DangerousPrototypes/bus_pirate_ng/README.md

# bus_pirate_ng
Bus Pirate NG firmware and hardware

Check the blog at http://dangerousprototypes.com/blog/2018/09/13/prototype-bus-pirate-next-gen-v1/
