DangerousPrototypes/bus_pirate_ng/(threads)

Thread 5 (2018-12-12):

DFuse format string

Squonk42, 2018-12-12:
https://github.com/DangerousPrototypes/bus_pirate_ng/blob/d68bd6ecd64ba1823aafadaffa73d94cadd74560/bootloader/usbdfu.c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

No, this is not correct for 128KB STM32 chips, according to [this](https://git.drak.xyz/flabbergast/opencm3-ex/src/commit/ef9fd2db6a21d4f1ae8ad4e156e27370e8926ce1/usb_dfu/usbdfu.c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), here is the correct format:
```
/* Notes about the dfuse string above:
 * /<start_address>/<number>*<page_size><multiplier><memtype>
 *  <number>: how many pages
 *  <page_size>: self explanatory
 *  <multiplier>: 'B'(ytes), 'K'(ilobytes), 'M'(egabytes)
 *  <memtype>: the bottom three bits are significant:
 *             writeable|erasable|readable
 * subsequent blocks separated by commas
 *
 * Using the internal page size: "@Internal Flash   /0x08000000/64*128Ba,448*128Bg"
 * Using 1K blocks: "@Internal Flash   /0x08000000/8*001Ka,56*001Kg"
 */

```

Thread 7 (2019-05-25):

Misc questions

FFY00, 2019-05-25:
1) Can you tell me if with the STM32 we get faster JTAG programming speeds?
2) Is there any ETA on the first stable hardware revision?
3) What is the current state of development?
4) Are there any gotchas?

I am considering building prototype and maybe help with the development.
