DangerousPrototypes/bus_pirate_ng/hardware/alpha3/BusPirate-ng.v1.0.brd

## EAGLE design hardware/alpha3/BusPirate-ng.v1.0.brd (2018-09-13)

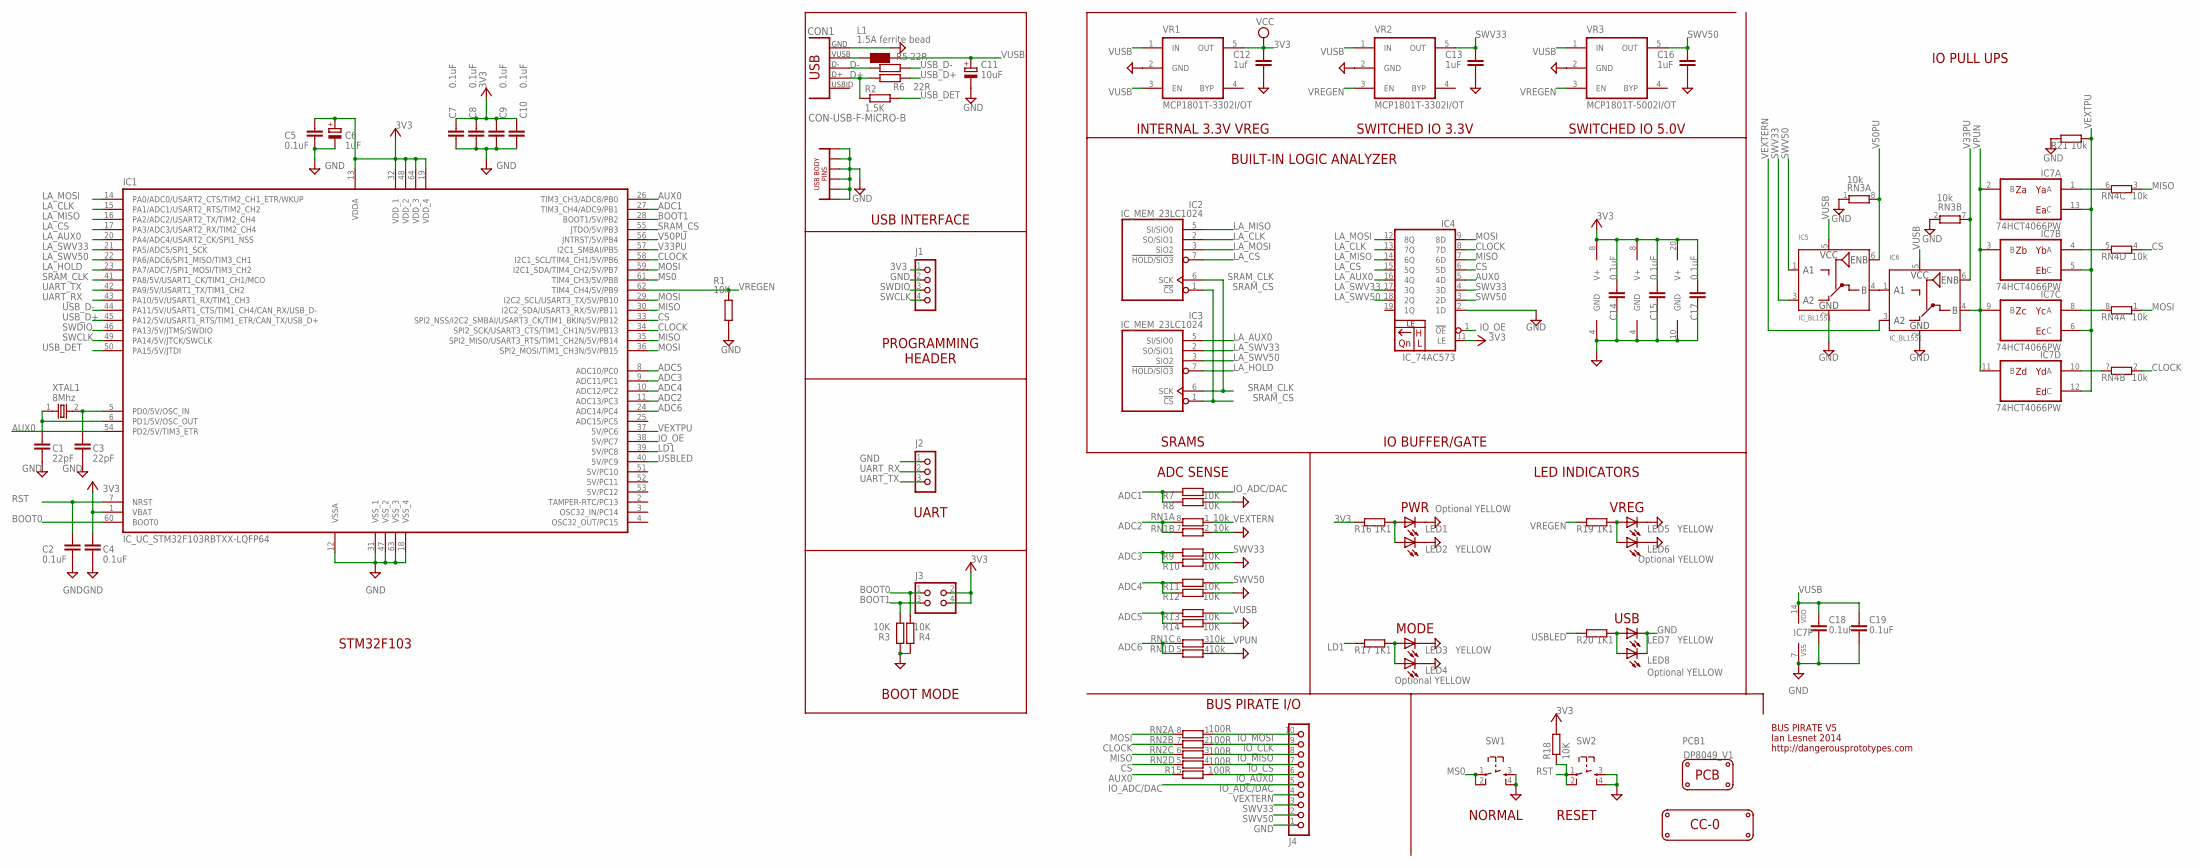
[picture p1: schematic BusPirate-ng.v1.0.sch]

Parts:
C1, C3: 22pF; C0603
C2, C4, C5, C7, C8, C9, C10, C14, C15, C17, C18, C19: 0.1uF; C0603
C6: 1uF; SMC_A
C11: 10uF; SMC_A
C12: 1uf; C0603
C13, C16: 1uF; C0603
CON1: CON-USB-F-MICRO-B; CON_USB_MICRO-B-1-MD05SMXXX-01
IC1: IC_UC_STM32F103RBTXX-LQFP64; LQFP64
IC2, IC3: IC_MEM_23LC1024; SOIC-8
IC4: IC_74AC573; TSSOP-20
IC5, IC6: IC_BL1551; SOT-363
IC7: 74HCT4066PW; 40XX_TSSOP14
J1: CON_HEADER_1X04; M1X4
J2: CON_HEADER_1X03-PTH; M1X3
J3: CON_HEADER_2X02-PTH; M2X2
J4: CON_HEADER_1X10-RIGHT_ANGLED_PTH_SHROUDED; M1X10_MALE_RIGHT_ANGLES_PTH_SHROUDED
L1: 1.5A ferrite bead; WE-KI_0805_B
LED1, LED4, LED6, LED8: Optional YELLOW; LED-805
LED2, LED3, LED5, LED7: YELLOW; LED-805
LOGO1: LOGO_CC-0
PCB1: PCB_DP_RECTANGLE-80X49; DP8049_V1
R1, R18: 10K; R603
R2: 1.5K; R603
R3, R4, R7, R8, R9, R10, R11, R12, R13, R14: 10K; R0603
R5, R6: 22R; R603
R15: 100R; R603
R16, R17, R19, R20: 1K1; R603
R21: 10k; R603
RN1, RN3, RN4: 10k; RN8P-4R-CRA06S
RN2: 100R; RN8P-4R-CRA06S
SW1, SW2: SW_TACT_4P; SW_TACT_SMALL
VR1, VR2: MCP1801T-3302I/OT; SOT-23-5@1
VR3: MCP1801T-5002I/OT; SOT-23-5@1
XTAL1: 8Mhz; XTAL_4X6

Connections:
3V3: C4.2, C5.2, C6.+, C7.2, C8.2, C9.2, C10.2, C12.1, C14.1, C15.1, C17.1, IC1.1 (VBAT), IC1.13 (VDDA), IC1.19 (VDD_4), IC1.32 (VDD_1), IC1.48 (VDD_2), IC1.64 (VDD_3), IC2.8 (V+), IC3.8 (V+), IC4.11 (LE), IC4.20 (V+), J1.1, J3.2, J3.4, R16.2, R18.2, VR1.5 (OUT)
ADC1: IC1.27 (TIM3_CH4/ADC9/PB1), R7.2, R8.2
ADC2: IC1.11 (ADC13/PC3), RN1.7 (2), RN1.8 (2)
ADC3: IC1.9 (ADC11/PC1), R9.2, R10.2
ADC4: IC1.10 (ADC12/PC2), R11.2, R12.2
ADC5: IC1.8 (ADC10/PC0), R13.2, R14.2
ADC6: IC1.24 (ADC14/PC4), RN1.5 (2), RN1.6 (2)
AUX0: IC1.26 (TIM3_CH3/ADC8/PB0), IC1.54 (PD2/5V/TIM3_ETR), IC4.5 (4D), R15.1
BOOT0: IC1.60 (BOOT0), J3.1, R4.1
BOOT1: IC1.28 (BOOT1/5V/PB2), J3.3, R3.1
CLOCK: IC1.34 (SPI2_SCK/USART3_CTS/TIM1_CH1N/5V/PB13), IC1.58 (I2C1_SCL/TIM4_CH1/5V/PB6), IC4.8 (7D), RN2.7 (2), RN4.2 (1)
CS: IC1.33 (SPI2_NSS/I2C2_SMBAI/USART3_CK/TIM1_BKIN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), IC4.6 (5D), RN2.5 (2), RN4.4 (1)
D+: CON1.P3 (D+), R2.1, R6.2
D-: CON1.P2 (D-), R5.2
EXVUSB: CON1.P1 (VUSB), L1.2 (1)
GND: C1.1, C2.1, C3.1, C4.1, C5.1, C6.-, C7.1, C8.1, C9.1, C10.1, C11.-, C12.2, C13.2, C14.2, C15.2, C16.2, C17.2, C18.2, C19.2, CON1.GND1, CON1.GND2, CON1.GND3, CON1.GND4, CON1.GND5, CON1.GND6, CON1.P5 (GND), IC1.12 (VSSA), IC1.18 (VSS_4), IC1.31 (VSS_1), IC1.47 (VSS_2), IC1.63 (VSS_3), IC2.4 (GND), IC3.4 (GND), IC4.2 (1D), IC4.10 (GND), IC5.2 (GND), IC6.2 (GND), IC7.7 (VSS), J1.2, J2.1, J4.1, LED1.C, LED2.C, LED3.C, LED4.C, LED5.C, LED6.C, LED7.C, LED8.C, R1.2, R3.2, R4.2, R8.1, R10.1, R12.1, R14.1, R21.2, RN1.2 (1), RN1.4 (1), RN3.1, RN3.2 (1), SW1.3, SW1.4, SW2.3, SW2.4, VR1.2 (GND), VR2.2 (GND), VR3.2 (GND)
IO_ADC/DAC: J4.5, R7.1
IO_AUX0: J4.6, R15.2
IO_CLK: J4.9, RN2.2 (1)
IO_CS: J4.7, RN2.4 (1)
IO_MISO: J4.8, RN2.3 (1)
IO_MOSI: J4.10, RN2.1
IO_OE: IC1.38 (5V/PC7), IC4.1 (!OE)
LA_AUX0: IC1.20 (PA4/ADC4/USART2_CK/SPI1_NSS), IC3.5 (SI/SIO0), IC4.16 (4Q)
LA_CLK: IC1.15 (PA1/ADC1/USART2_RTS/TIM2_CH2), IC2.2 (SO/SIO1), IC4.13 (7Q)
LA_CS: IC1.17 (PA3/ADC3/USART2_RX/TIM2_CH4), IC2.7 (!HOLD/SIO3), IC4.15 (5Q)
LA_HOLD: IC1.23 (PA7/ADC7/SPI1_MOSI/TIM3_CH2), IC3.7 (!HOLD/SIO3)
LA_MISO: IC1.16 (PA2/ADC2/USART2_TX/TIM2_CH4), IC2.5 (SI/SIO0), IC4.14 (6Q)
LA_MOSI: IC1.14 (PA0/ADC0/USART2_CTS/TIM2_CH1_ETR/WKUP), IC2.3 (SIO2), IC4.12 (8Q)
LA_SWV33: IC1.21 (PA5/ADC5/SPI1_SCK), IC3.2 (SO/SIO1), IC4.17 (3Q)
LA_SWV50: IC1.22 (PA6/ADC6/SPI1_MISO/TIM3_CH1), IC3.3 (SIO2), IC4.18 (2Q)
LD1: IC1.39 (5V/PC8), R17.2
MISO: IC1.30 (I2C2_SDA/USART3_RX/5V/PB11), IC1.35 (SPI2_MISO/USART3_RTS/TIM1_CH2N/5V/PB14), IC4.7 (6D), RN2.6 (2), RN4.3 (1)
MOSI: IC1.29 (I2C2_SCL/USART3_TX/5V/PB10), IC1.36 (SPI2_MOSI/TIM1_CH3N/5V/PB15), IC1.59 (I2C1_SDA/TIM4_CH2/5V/PB7), IC4.9 (8D), RN2.8 (2), RN4.1
MS0: IC1.61 (TIM4_CH3/5V/PB8), SW1.1, SW1.2
unnamed: IC5.4 (B), IC6.1 (A1)
unnamed: IC7.1 (A), RN4.6 (2)
unnamed: IC7.4 (A), RN4.5 (2)
unnamed: IC7.8 (A), RN4.8 (2)
unnamed: IC7.10 (A), RN4.7 (2)
unnamed: LED3.A, LED4.A, R17.1
unnamed: LED1.A, LED2.A, R16.1
unnamed: LED7.A, LED8.A, R20.1
unnamed: C3.2, IC1.5 (PD0/5V/OSC_IN), XTAL1.2
unnamed: LED5.A, LED6.A, R19.1
unnamed: C1.2, IC1.6 (PD1/5V/OSC_OUT), XTAL1.1
RST: C2.2, IC1.7 (NRST), R18.1, SW2.1, SW2.2
SRAM_CLK: IC1.41 (PA8/5V/USART1_CK/TIM1_CH1/MCO), IC2.6 (SCK), IC3.6 (SCK)
SRAM_CS: IC1.55 (JTDO/5V/PB3), IC2.1 (!CS), IC3.1 (!CS)
SWCLK: IC1.49 (PA14/5V/JTCK/SWCLK), J1.4
SWDIO: IC1.46 (PA13/5V/JTMS/SWDIO), J1.3
SWV33: C13.1, IC4.4 (3D), IC5.3 (A2), J4.3, R9.1, VR2.5 (OUT)
SWV50: C16.1, IC4.3 (2D), IC5.1 (A1), J4.2, R11.1, VR3.5 (OUT)
UART_RX: IC1.43 (PA10/5V/USART1_RX/TIM1_CH3), J2.2
UART_TX: IC1.42 (PA9/5V/USART1_TX/TIM1_CH2), J2.3
USBLED: IC1.40 (5V/PC9), R20.2
USB_D+: IC1.45 (PA12/5V/USART1_RTS/TIM1_ETR/CAN_TX/USB_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), R6.1
USB_D-: IC1.44 (PA11/5V/USART1_CTS/TIM1_CH4/CAN_RX/USB_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), R5.1
USB_DET: IC1.50 (PA15/5V/JTDI), R2.2
V33PU: IC1.57 (I2C1_SMBAI/PB5), IC6.6 (ENB), RN3.7 (2)
V50PU: IC1.56 (JNTRST/5V/PB4), IC5.6 (ENB), RN3.8 (2)
VEXTERN: IC6.3 (A2), J4.4, RN1.1
VEXTPU: IC1.37 (5V/PC6), IC7.5 (C), IC7.6 (C), IC7.12 (C), IC7.13 (C), R21.1
VPUN: IC6.4 (B), IC7.2 (B), IC7.3 (B), IC7.9 (B), IC7.11 (B), RN1.3 (1)
VREGEN: IC1.62 (TIM4_CH4/5V/PB9), R1.1, R19.2, VR2.3 (EN), VR3.3 (EN)
VUSB: C11.+, C18.1, C19.1, IC5.5 (VCC), IC6.5 (VCC), IC7.14 (VDD), L1.1 (2), R13.1, VR1.1 (IN), VR1.3 (EN), VR2.1 (IN), VR3.1 (IN)

Notes on the sheet:
BUS PIRATE V5
Ian Lesnet 2014
http://dangerousprototypes.com
SRAMS
IO BUFFER/GATE
BUS PIRATE I/O
BOOT MODE
PWR
MODE
VREG
PROGRAMMING HEADER
USB
INTERNAL 3.3V VREG
SWITCHED IO 3.3V
SWITCHED IO 5.0V
BUILT-IN LOGIC ANALYZER
ADC SENSE
USB INTERFACE
STM32F103
NORMAL
RESET
IO PULL UPS
LED INDICATORS
UART

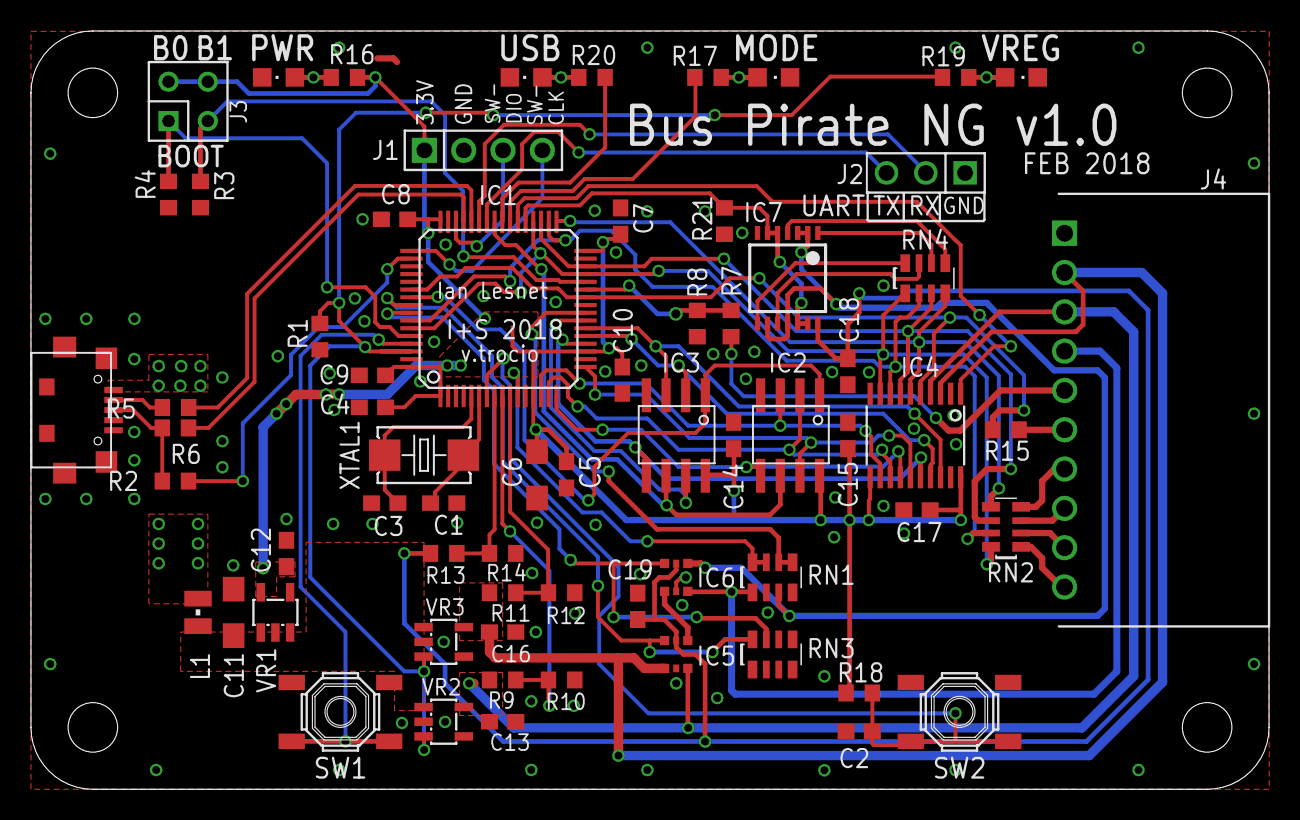
[picture p2: board BusPirate-ng.v1.0.brd from above]

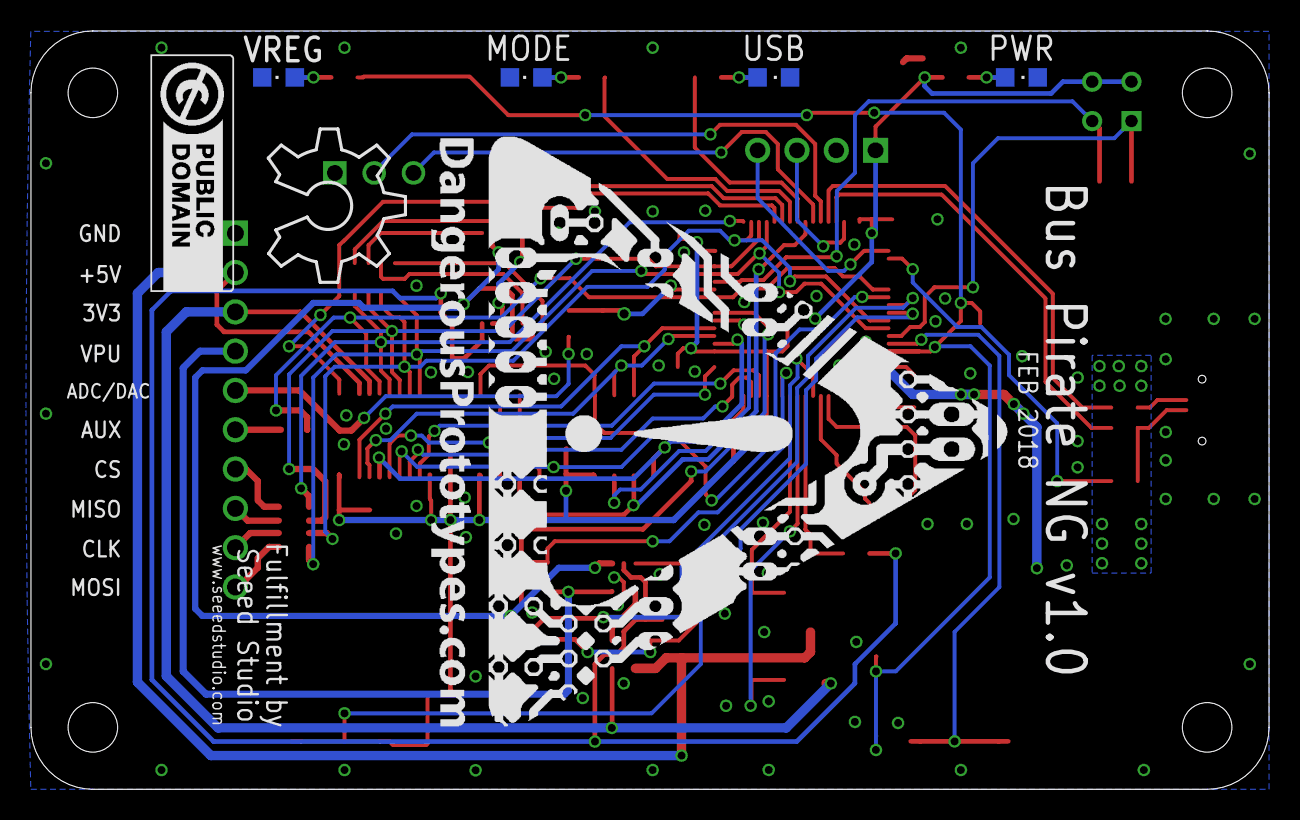
[picture p3: board BusPirate-ng.v1.0.brd from below]

Board: 2 copper layers, 80.0 x 49.0 mm, 76 parts (7 on the bottom side), 66 nets.

Other parts of the board:
U$1: DP-LOGO
U$2: OSHW_8X350_NOTEXT
U$4: DP_LOGO_ART_1.5X1.5
