DangerousPrototypes/bus_pirate_ng/hardware/alpha1/BusPirate-v5.brd

## EAGLE design hardware/alpha1/BusPirate-v5.brd (2017-12-20)

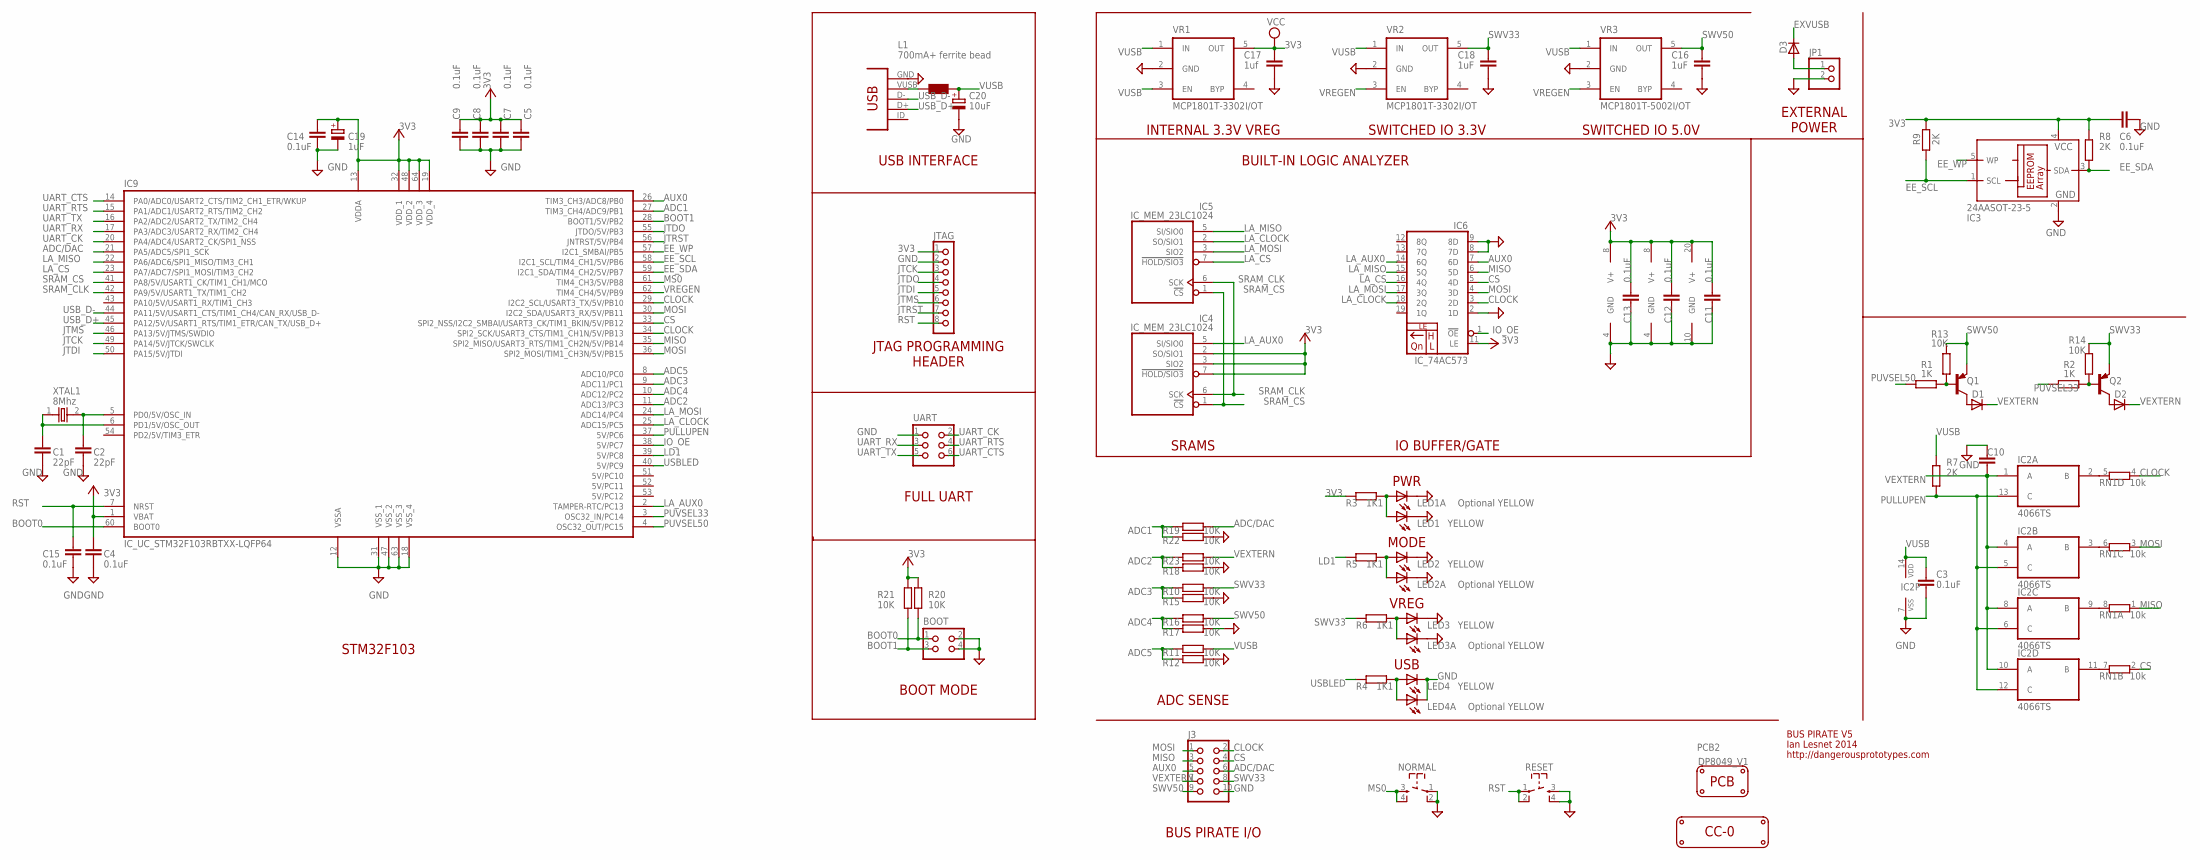
[picture p4: schematic BusPirate-v5.sch]

Parts:
BOOT: CON_HEADER_2X02-PTH; M2X2
C1, C2: 22pF; C0603
C3, C4, C5, C6, C7, C8, C9, C10, C11, C12, C13, C14, C15: 0.1uF; C0603
C16, C18: 1uF; C0603
C17: 1uf; C0603
C19: 1uF; SMC_A
C20: 10uF; SMC_A
D1, D2, D3: MBR0520LT; SOD123
IC2: 4066TS; 40XX_TSSOP14
IC3: 24AASOT-23-5; SOT-23-5@1
IC4, IC5: IC_MEM_23LC1024; SOIC-8
IC6: IC_74AC573; TSSOP-20
IC9: IC_UC_STM32F103RBTXX-LQFP64; LQFP64
J3: CON_HEADER_2X05-PTH+SHROUDED_A; PINSHRD_PTH_2X05
JP1: PINHD-1X02_2.54-S; 1X02-S
JTAG: CON_HEADER_1X08-PTH; M1X8
L1: 700mA+ ferrite bead; WE-KI_0805_B
LED1, LED2, LED3, LED4: YELLOW; LED-603
LED1A, LED2A, LED3A, LED4A: Optional YELLOW; LED-603
LOGO1: LOGO_CC-0
NORMAL: SW_TACT_4P; SW_TACT_SMALL
PCB2: PCB_DP_RECTANGLE-80X49; DP8049_V1
Q1, Q2: MMBTA56-SOT23; SOT23
R1, R2: 1K; R0603
R3, R4, R5, R6: 1K1; R603
R7, R8, R9: 2K; R0603
R10, R11, R12, R14, R15, R16, R17, R18, R19, R20, R21, R22, R23: 10K; R0603
R13: 10K; R603
RESET: SW_TACT_4P; SW_TACT_SMALL
RN1: 10k; RN8P-4R-CRA06S
UART: CON_HEADER_2X03-PTH; M2X3
USB: USB mini-b; CONN_USB_MINI-B
VR1, VR2: MCP1801T-3302I/OT; SOT-23-5@1
VR3: MCP1801T-5002I/OT; SOT-23-5@1
XTAL1: 8Mhz; XTAL_4X6

Connections:
3V3: C4.2, C5.2, C6.1, C7.2, C8.2, C9.2, C11.1, C12.1, C13.1, C14.2, C17.1, C19.+, IC3.4 (VCC), IC4.2 (SO/SIO1), IC4.3 (SIO2), IC4.7 (!HOLD/SIO3), IC4.8 (V+), IC5.8 (V+), IC6.11 (LE), IC6.20 (V+), IC9.1 (VBAT), IC9.13 (VDDA), IC9.19 (VDD_4), IC9.32 (VDD_1), IC9.48 (VDD_2), IC9.64 (VDD_3), JTAG.1, R3.2, R8.2, R9.2, R20.2, R21.2, VR1.5 (OUT)
ADC1: IC9.27 (TIM3_CH4/ADC9/PB1), R19.2, R22.2
ADC2: IC9.11 (ADC13/PC3), R18.2, R23.2
ADC3: IC9.9 (ADC11/PC1), R10.2, R15.2
ADC4: IC9.10 (ADC12/PC2), R16.2, R17.2
ADC5: IC9.8 (ADC10/PC0), R11.2, R12.2
ADC/DAC: IC9.21 (PA5/ADC5/SPI1_SCK), J3.6, R19.1
AUX0: IC6.7 (6D), IC9.26 (TIM3_CH3/ADC8/PB0), J3.5
BOOT0: BOOT.1, IC9.60 (BOOT0), R20.1
BOOT1: BOOT.3, IC9.28 (BOOT1/5V/PB2), R21.1
CLOCK: IC6.3 (2D), IC9.29 (I2C2_SCL/USART3_TX/5V/PB10), IC9.34 (SPI2_SCK/USART3_CTS/TIM1_CH1N/5V/PB13), J3.2, RN1.4 (1)
CS: IC6.5 (4D), IC9.33 (SPI2_NSS/I2C2_SMBAI/USART3_CK/TIM1_BKIN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), J3.4, RN1.2 (1)
EE_SCL: IC3.1 (SCL), IC9.58 (I2C1_SCL/TIM4_CH1/5V/PB6), R9.1
EE_SDA: IC3.3 (SDA), IC9.59 (I2C1_SDA/TIM4_CH2/5V/PB7), R8.1
EE_WP: IC3.5 (WP), IC9.57 (I2C1_SMBAI/PB5)
EXVUSB: D3.C, L1.2 (1), USB.VUSB
GND: BOOT.2, BOOT.4, C1.1, C2.1, C3.2, C4.1, C5.1, C6.2, C7.1, C8.1, C9.1, C10.2, C11.2, C12.2, C13.2, C14.1, C15.1, C16.2, C17.2, C18.2, C19.-, C20.-, IC2.7 (VSS), IC3.2 (GND), IC4.4 (GND), IC5.4 (GND), IC6.2 (1D), IC6.8 (7D), IC6.9 (8D), IC6.10 (GND), IC9.12 (VSSA), IC9.18 (VSS_4), IC9.31 (VSS_1), IC9.47 (VSS_2), IC9.63 (VSS_3), J3.10, JP1.2, JTAG.2, LED1.C, LED1A.C, LED2.C, LED2A.C, LED3.C, LED3A.C, LED4.C, LED4A.C, NORMAL.1, NORMAL.2, R12.1, R15.1, R17.1, R18.1, R22.1, RESET.3, RESET.4, UART.1, USB.GND, VR1.2 (GND), VR2.2 (GND), VR3.2 (GND)
IO_OE: IC6.1 (!OE), IC9.38 (5V/PC7)
JTCK: IC9.49 (PA14/5V/JTCK/SWCLK), JTAG.3
JTDI: IC9.50 (PA15/5V/JTDI), JTAG.5
JTDO: IC9.55 (JTDO/5V/PB3), JTAG.4
JTMS: IC9.46 (PA13/5V/JTMS/SWDIO), JTAG.6
JTRST: IC9.56 (JNTRST/5V/PB4), JTAG.7
LA_AUX0: IC4.5 (SI/SIO0), IC6.14 (6Q), IC9.2 (TAMPER-RTC/PC13)
LA_CLOCK: IC5.2 (SO/SIO1), IC6.18 (2Q), IC9.25 (ADC15/PC5)
LA_CS: IC5.7 (!HOLD/SIO3), IC6.16 (4Q), IC9.23 (PA7/ADC7/SPI1_MOSI/TIM3_CH2)
LA_MISO: IC5.5 (SI/SIO0), IC6.15 (5Q), IC9.22 (PA6/ADC6/SPI1_MISO/TIM3_CH1)
LA_MOSI: IC5.3 (SIO2), IC6.17 (3Q), IC9.24 (ADC14/PC4)
LD1: IC9.39 (5V/PC8), R5.2
MISO: IC6.6 (5D), IC9.35 (SPI2_MISO/USART3_RTS/TIM1_CH2N/5V/PB14), J3.3, RN1.1
MOSI: IC6.4 (3D), IC9.30 (I2C2_SDA/USART3_RX/5V/PB11), IC9.36 (SPI2_MOSI/TIM1_CH3N/5V/PB15), J3.1, RN1.3 (1)
MS0: IC9.61 (TIM4_CH3/5V/PB8), NORMAL.3, NORMAL.4
unnamed: IC2.2 (B), RN1.5 (2)
unnamed: IC2.11 (B), RN1.7 (2)
unnamed: D1.A, Q1.3 (C)
unnamed: IC2.9 (B), RN1.8 (2)
unnamed: IC2.3 (B), RN1.6 (2)
unnamed: LED2.A, LED2A.A, R5.1
unnamed: LED1.A, LED1A.A, R3.1
unnamed: Q2.1 (B), R2.1, R14.2
unnamed: LED4.A, LED4A.A, R4.1
unnamed: D2.A, Q2.3 (C)
unnamed: D3.A, JP1.1
unnamed: C2.2, IC9.5 (PD0/5V/OSC_IN), XTAL1.2
unnamed: Q1.1 (B), R1.1, R13.2
unnamed: LED3.A, LED3A.A, R6.1
unnamed: C1.2, IC9.6 (PD1/5V/OSC_OUT), XTAL1.1
PULLUPEN: IC2.5 (C), IC2.6 (C), IC2.12 (C), IC2.13 (C), IC9.37 (5V/PC6), R7.2
PUVSEL33: IC9.3 (OSC32_IN/PC14), R2.2
PUVSEL50: IC9.4 (OSC32_OUT/PC15), R1.2
RST: C15.2, IC9.7 (NRST), JTAG.8, RESET.1, RESET.2
SRAM_CLK: IC4.6 (SCK), IC5.6 (SCK), IC9.42 (PA9/5V/USART1_TX/TIM1_CH2)
SRAM_CS: IC4.1 (!CS), IC5.1 (!CS), IC9.41 (PA8/5V/USART1_CK/TIM1_CH1/MCO)
SWV33: C18.1, J3.8, Q2.2 (E), R6.2, R10.1, R14.1, VR2.5 (OUT)
SWV50: C16.1, J3.9, Q1.2 (E), R13.1, R16.1, VR3.5 (OUT)
UART_CK: IC9.20 (PA4/ADC4/USART2_CK/SPI1_NSS), UART.2
UART_CTS: IC9.14 (PA0/ADC0/USART2_CTS/TIM2_CH1_ETR/WKUP), UART.6
UART_RTS: IC9.15 (PA1/ADC1/USART2_RTS/TIM2_CH2), UART.4
UART_RX: IC9.17 (PA3/ADC3/USART2_RX/TIM2_CH4), UART.3
UART_TX: IC9.16 (PA2/ADC2/USART2_TX/TIM2_CH4), UART.5
USBLED: IC9.40 (5V/PC9), R4.2
USB_D+: IC9.45 (PA12/5V/USART1_RTS/TIM1_ETR/CAN_TX/USB_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), USB.D+
USB_D-: IC9.44 (PA11/5V/USART1_CTS/TIM1_CH4/CAN_RX/USB_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), USB.D-
VEXTERN: C10.1, D1.C, D2.C, IC2.1 (A), IC2.4 (A), IC2.8 (A), IC2.10 (A), J3.7, R23.1
VREGEN: IC9.62 (TIM4_CH4/5V/PB9), VR2.3 (EN), VR3.3 (EN)
VUSB: C3.1, C20.+, IC2.14 (VDD), L1.1 (2), R7.1, R11.1, VR1.1 (IN), VR1.3 (EN), VR2.1 (IN), VR3.1 (IN)

Notes on the sheet:
BUS PIRATE V5
Ian Lesnet 2014
http://dangerousprototypes.com
SRAMS
IO BUFFER/GATE
FULL UART
BUS PIRATE I/O
BOOT MODE
PWR
MODE
VREG
JTAG PROGRAMMING HEADER
USB
INTERNAL 3.3V VREG
SWITCHED IO 3.3V
SWITCHED IO 5.0V
BUILT-IN LOGIC ANALYZER
ADC SENSE
USB INTERFACE
STM32F103
EXTERNAL POWER

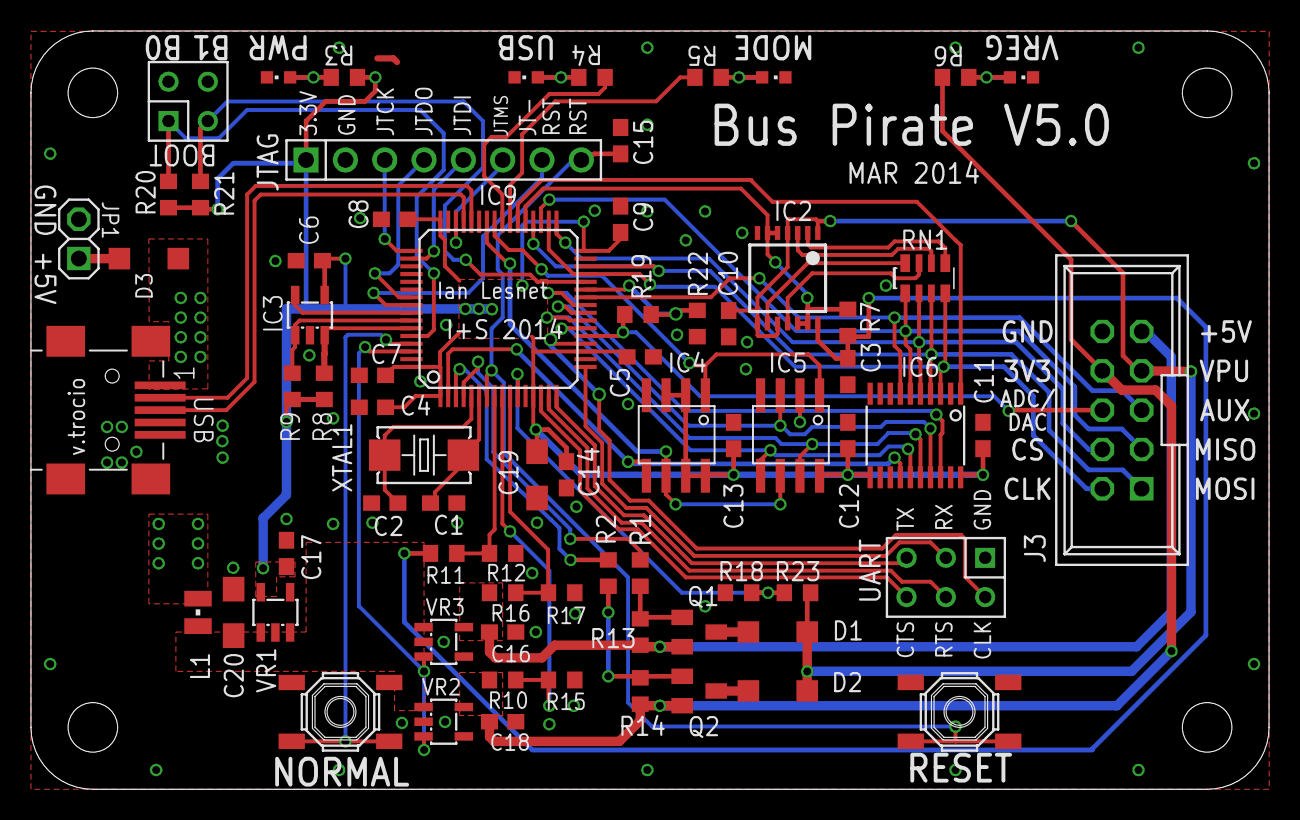
[picture p5: board BusPirate-v5.brd from above]

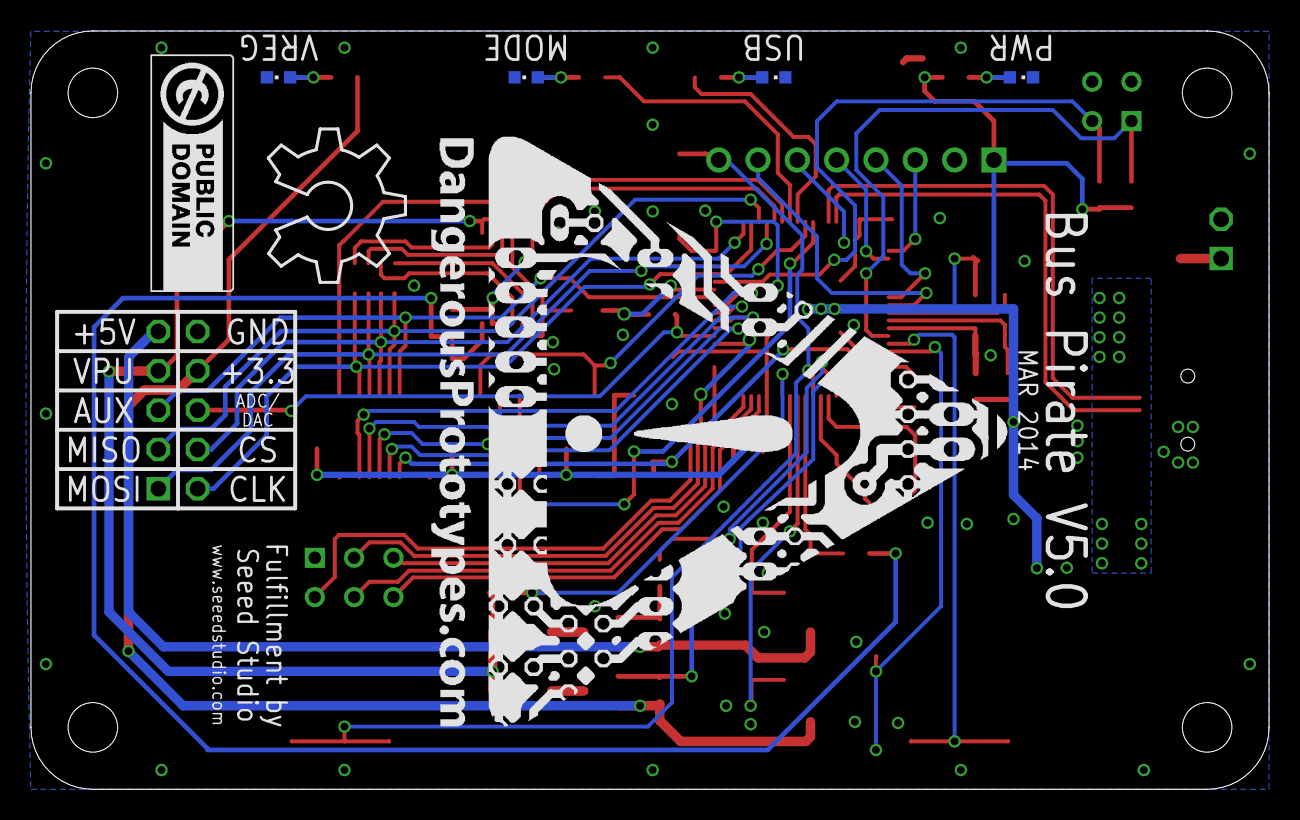
[picture p6: board BusPirate-v5.brd from below]

Board: 2 copper layers, 80.0 x 49.0 mm, 80 parts (7 on the bottom side), 66 nets.

Other parts of the board:
U$2: OSHW_8X350_NOTEXT
U$4: DP_LOGO_ART_1.5X1.5
