DangerousPrototypes/bus_pirate_ng/source/usbdescriptor.h

#ifndef USB_VID
#error "USB_VID not defined; we need this to function!!"
#endif
#ifndef USB_PID
#error "USB_PID not defined; we need this to function!!"
#endif

extern char usbserial[25];

static const struct usb_device_descriptor dev = {
	.bLength = USB_DT_DEVICE_SIZE,
	.bDescriptorType = USB_DT_DEVICE,
	.bcdUSB = 0x0200,
	.bDeviceClass = 0xEF,
	.bDeviceSubClass = 2,
	.bDeviceProtocol = 1,
	.bMaxPacketSize0 = 64,
	.idVendor = 0x1209,
	.idProduct = 0x7331,
	.bcdDevice = 0x0101,
	.iManufacturer = 1,
	.iProduct = 2,
	.iSerialNumber = 3,
	.bNumConfigurations = 1,
};

/*
 * This notification endpoint isn't implemented. According to CDC spec its
 * optional, but its absence causes a NULL pointer dereference in Linux
 * cdc_acm driver.
 */
static const struct usb_endpoint_descriptor comm1_endp[] = {{
	.bLength = USB_DT_ENDPOINT_SIZE,
	.bDescriptorType = USB_DT_ENDPOINT,
	.bEndpointAddress = 0x82,
	.bmAttributes = USB_ENDPOINT_ATTR_INTERRUPT,
	.wMaxPacketSize = 16,
	.bInterval = 255,
}};

static const struct usb_endpoint_descriptor data1_endp[] = {{
	.bLength = USB_DT_ENDPOINT_SIZE,
	.bDescriptorType = USB_DT_ENDPOINT,
	.bEndpointAddress = 0x01,
	.bmAttributes = USB_ENDPOINT_ATTR_BULK,
	.wMaxPacketSize = 64,
	.bInterval = 1,
}, {
	.bLength = USB_DT_ENDPOINT_SIZE,
	.bDescriptorType = USB_DT_ENDPOINT,
	.bEndpointAddress = 0x81,
	.bmAttributes = USB_ENDPOINT_ATTR_BULK,
	.wMaxPacketSize = 64,
	.bInterval = 1,
}};

static const struct usb_endpoint_descriptor comm2_endp[] = {{
	.bLength = USB_DT_ENDPOINT_SIZE,
	.bDescriptorType = USB_DT_ENDPOINT,
	.bEndpointAddress = 0x84,
	.bmAttributes = USB_ENDPOINT_ATTR_INTERRUPT,
	.wMaxPacketSize = 16,
	.bInterval = 255,
}};

static const struct usb_endpoint_descriptor data2_endp[] = {{
	.bLength = USB_DT_ENDPOINT_SIZE,
	.bDescriptorType = USB_DT_ENDPOINT,
	.bEndpointAddress = 0x03,
	.bmAttributes = USB_ENDPOINT_ATTR_BULK,
	.wMaxPacketSize = 64,
	.bInterval = 1,
}, {
	.bLength = USB_DT_ENDPOINT_SIZE,
	.bDescriptorType = USB_DT_ENDPOINT,
	.bEndpointAddress = 0x83,
	.bmAttributes = USB_ENDPOINT_ATTR_BULK,
	.wMaxPacketSize = 64,
	.bInterval = 1,
}};

static const struct {
	struct usb_cdc_header_descriptor header;
	struct usb_cdc_call_management_descriptor call_mgmt;
	struct usb_cdc_acm_descriptor acm;
	struct usb_cdc_union_descriptor cdc_union;
} __attribute__((packed)) cdcacm1_functional_descriptors = {
	.header = {
		.bFunctionLength = sizeof(struct usb_cdc_header_descriptor),
		.bDescriptorType = CS_INTERFACE,
		.bDescriptorSubtype = USB_CDC_TYPE_HEADER,
		.bcdCDC = 0x0110,
	},
	.call_mgmt = {
		.bFunctionLength = 
			sizeof(struct usb_cdc_call_management_descriptor),
		.bDescriptorType = CS_INTERFACE,
		.bDescriptorSubtype = USB_CDC_TYPE_CALL_MANAGEMENT,
		.bmCapabilities = 0,
		.bDataInterface = 1,
	},
	.acm = {
		.bFunctionLength = sizeof(struct usb_cdc_acm_descriptor),
		.bDescriptorType = CS_INTERFACE,
		.bDescriptorSubtype = USB_CDC_TYPE_ACM,
		.bmCapabilities = 0,
	},
	.cdc_union = {
		.bFunctionLength = sizeof(struct usb_cdc_union_descriptor),
		.bDescriptorType = CS_INTERFACE,
		.bDescriptorSubtype = USB_CDC_TYPE_UNION,
		.bControlInterface = 0,
		.bSubordinateInterface0 = 1, 
	 }
};

static const struct {
	struct usb_cdc_header_descriptor header;
	struct usb_cdc_call_management_descriptor call_mgmt;
	struct usb_cdc_acm_descriptor acm;
	struct usb_cdc_union_descriptor cdc_union;
} __attribute__((packed)) cdcacm2_functional_descriptors = {
	.header = {
		.bFunctionLength = sizeof(struct usb_cdc_header_descriptor),
		.bDescriptorType = CS_INTERFACE,
		.bDescriptorSubtype = USB_CDC_TYPE_HEADER,
		.bcdCDC = 0x0110,
	},
	.call_mgmt = {
		.bFunctionLength = 
			sizeof(struct usb_cdc_call_management_descriptor),
		.bDescriptorType = CS_INTERFACE,
		.bDescriptorSubtype = USB_CDC_TYPE_CALL_MANAGEMENT,
		.bmCapabilities = 0,
		.bDataInterface = 3,
	},
	.acm = {
		.bFunctionLength = sizeof(struct usb_cdc_acm_descriptor),
		.bDescriptorType = CS_INTERFACE,
		.bDescriptorSubtype = USB_CDC_TYPE_ACM,
		.bmCapabilities = 0,
	},
	.cdc_union = {
		.bFunctionLength = sizeof(struct usb_cdc_union_descriptor),
		.bDescriptorType = CS_INTERFACE,
		.bDescriptorSubtype = USB_CDC_TYPE_UNION,
		.bControlInterface = 2,
		.bSubordinateInterface0 = 3, 
	 }
};

static const struct usb_interface_descriptor comm1_iface[] = {{
	.bLength = USB_DT_INTERFACE_SIZE,
	.bDescriptorType = USB_DT_INTERFACE,
	.bInterfaceNumber = 0,
	.bAlternateSetting = 0,
	.bNumEndpoints = 1,
	.bInterfaceClass = USB_CLASS_CDC,
	.bInterfaceSubClass = USB_CDC_SUBCLASS_ACM,
	.bInterfaceProtocol = USB_CDC_PROTOCOL_AT,
	.iInterface = 0,

	.endpoint = comm1_endp,

	.extra = &cdcacm1_functional_descriptors,
	.extralen = sizeof(cdcacm1_functional_descriptors)
}};

static const struct usb_interface_descriptor data1_iface[] = {{
	.bLength = USB_DT_INTERFACE_SIZE,
	.bDescriptorType = USB_DT_INTERFACE,
	.bInterfaceNumber = 1,
	.bAlternateSetting = 0,
	.bNumEndpoints = 2,
	.bInterfaceClass = USB_CLASS_DATA,
	.bInterfaceSubClass = 0,
	.bInterfaceProtocol = 0,
	.iInterface = 0,

	.endpoint = data1_endp,
}};

static const struct usb_iface_assoc_descriptor uart1_assoc = {
	.bLength = USB_DT_INTERFACE_ASSOCIATION_SIZE,
	.bDescriptorType = USB_DT_INTERFACE_ASSOCIATION,
	.bFirstInterface = 0,
	.bInterfaceCount = 2,
	.bFunctionClass = USB_CLASS_CDC,
	.bFunctionSubClass = USB_CDC_SUBCLASS_ACM,
	.bFunctionProtocol = USB_CDC_PROTOCOL_AT,
	.iFunction = 0,
};

static const struct usb_interface_descriptor comm2_iface[] = {{
	.bLength = USB_DT_INTERFACE_SIZE,
	.bDescriptorType = USB_DT_INTERFACE,
	.bInterfaceNumber = 2,
	.bAlternateSetting = 0,
	.bNumEndpoints = 1,
	.bInterfaceClass = USB_CLASS_CDC,
	.bInterfaceSubClass = USB_CDC_SUBCLASS_ACM,
	.bInterfaceProtocol = USB_CDC_PROTOCOL_AT,
	.iInterface = 0,

	.endpoint = comm2_endp,

	.extra = &cdcacm2_functional_descriptors,
	.extralen = sizeof(cdcacm2_functional_descriptors)
}};

static const struct usb_interface_descriptor data2_iface[] = {{
	.bLength = USB_DT_INTERFACE_SIZE,
	.bDescriptorType = USB_DT_INTERFACE,
	.bInterfaceNumber = 3,
	.bAlternateSetting = 0,
	.bNumEndpoints = 2,
	.bInterfaceClass = USB_CLASS_DATA,
	.bInterfaceSubClass = 0,
	.bInterfaceProtocol = 0,
	.iInterface = 0,

	.endpoint = data2_endp,
}};

static const struct usb_iface_assoc_descriptor uart2_assoc = {
	.bLength = USB_DT_INTERFACE_ASSOCIATION_SIZE,
	.bDescriptorType = USB_DT_INTERFACE_ASSOCIATION,
	.bFirstInterface = 2,
	.bInterfaceCount = 2,
	.bFunctionClass = USB_CLASS_CDC,
	.bFunctionSubClass = USB_CDC_SUBCLASS_ACM,
	.bFunctionProtocol = USB_CDC_PROTOCOL_AT,
	.iFunction = 0,
};


static const struct usb_interface ifaces[] = {{
	.num_altsetting = 1,
	.iface_assoc=&uart1_assoc,
	.altsetting = comm1_iface,
}, {
	.num_altsetting = 1,
	.altsetting = data1_iface,
}, {
	.num_altsetting = 1,
	.iface_assoc=&uart2_assoc,
	.altsetting = comm2_iface,
}, {
	.num_altsetting = 1,
	.altsetting = data2_iface,
}};

static const struct usb_config_descriptor config = {
	.bLength = USB_DT_CONFIGURATION_SIZE,
	.bDescriptorType = USB_DT_CONFIGURATION,
	.wTotalLength = 0,
	.bNumInterfaces = 4,
	.bConfigurationValue = 1,
	.iConfiguration = 0,
	.bmAttributes = 0x80,
	.bMaxPower = 0x32,

	.interface = ifaces,
};



static const char *usb_strings[] = {
	USB_VENDOR,
	USB_PRODUCT,
	usbserial,
};
