DangerousPrototypes/bus_pirate_ng/source/SW2W.h

void SW2W_start(void);
void SW2W_startr(void);
void SW2W_stop(void);
void SW2W_stopr(void);
uint32_t SW2W_send(uint32_t d);
uint32_t SW2W_read(void);
void SW2W_clkh(void);
void SW2W_clkl(void);
void SW2W_dath(void);
void SW2W_datl(void);
uint32_t SW2W_dats(void);
void SW2W_clk(void);
uint32_t SW2W_bitr(void);
uint32_t SW2W_period(void);
void SW2W_macro(uint32_t macro);
void SW2W_setup(void);
void SW2W_setup_exc(void);
void SW2W_cleanup(void);
void SW2W_pins(void);
void SW2W_settings(void);

void setSDAmode(uint8_t input);

#define SW2W_INPUT	1
#define SW2W_OUTPUT	0
