DangerousPrototypes/bus_pirate_ng/source/dummy1.h

void dummy1_start(void);
void dummy1_startr(void);
void dummy1_stop(void);
void dummy1_stopr(void);
uint32_t dummy1_send(uint32_t d);
uint32_t dummy1_read(void);
void dummy1_clkh(void);
void dummy1_clkl(void);
void dummy1_dath(void);
void dummy1_datl(void);
uint32_t dummy1_dats(void);
void dummy1_clk(void);
uint32_t dummy1_bitr(void);
uint32_t dummy1_period(void);
void dummy1_macro(uint32_t macro);
void dummy1_setup(void);
void dummy1_setup_exc(void);
void dummy1_cleanup(void);
void dummy1_pins(void);
void dummy1_settings(void);
