DangerousPrototypes/bus_pirate_ng/source/dummy2.h

void dummy2_start(void);
void dummy2_startr(void);
void dummy2_stop(void);
void dummy2_stopr(void);
uint32_t dummy2_send(uint32_t d);
uint32_t dummy2_read(void);
void dummy2_clkh(void);
void dummy2_clkl(void);
void dummy2_dath(void);
void dummy2_datl(void);
uint32_t dummy2_dats(void);
void dummy2_clk(void);
uint32_t dummy2_bitr(void);
uint32_t dummy2_period(void);
void dummy2_macro(uint32_t macro);
void dummy2_setup(void);
void dummy2_setup_exc(void);
void dummy2_cleanup(void);
void dummy2_pins(void);
void dummy2_settings(void);
