DangerousPrototypes/bus_pirate_ng/(commit log)

2017-11-29 added morecore commands and SPI protocol
2017-11-29 removed usb vid/pid
2017-12-06 add UART and improved core
2017-12-19 added I2C protocol
2017-12-20 bus pirate ng licenses and boards for USB VID/PID approval
    [BusPirate-v5.GBL, BusPirate-v5.GBO, BusPirate-v5.GBP, BusPirate-v5.GBS, BusPirate-v5.GTL, BusPirate-v5.GTO, BusPirate-v5.GTP, BusPirate-v5.GTS]
2017-12-20 fixed error in integer parser and fixed i2c read (for now)
    [HWI2C.c, UI.c]
2017-12-21 Added PWM function to core
2017-12-29 - fixed a bug in getint() - added macro handler - some preliminary logic analyzer code
    [LA.c, LA.h, UI.c, buspirateNG.h, protocols.c, protocols.h, testplatform.h]
2018-01-01 - added ANSI codes for colors/textstyles - added send string - implemented the bitorder switch
2018-01-09 - added software 3wire (SPI like) - minor UI tweaks - cleaned up protocols - removed some visual debugging
2018-01-17 - removed lots of 'debugging' from the protocols - fixed HWSPI - removed unused commands from the protocols
    [HWI2C.c, HWI2C.h, HWSPI.c, HWSPI.h, HWUSART.c, HWUSART.h, HiZ.c, protocols.c]
2018-01-17 - fixed naming in SPI
    [HWSPI.c, testplatform.h]
2018-01-18 - added software 2 wire (I2C like) - add comments
2018-01-23 - cleaned up code - renamed defines in platform (better readable) - add protocol specific help (only I2C for now)
2018-01-24 added protocol help for SPI, USART, software 3 wire
2018-01-26 - added periodic function to protocols - determine the mode of the pin (i menu)
2018-02-08 - added support for first beta HW (platform/beta1.h - added support for mode, usb LEDs - usb pullup is configurable - fixed bugs in sw3w: now sets states of CS and CLK correctly - fixed bugs in hwuas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
    [AUXpin.c, HWSPI.c, HWUSART.c, HiZ.c, SW3W.c, UI.c, beta1.h, buspirateNG.c]
2018-02-21 initial logic analyzer code. WIP/not working yet
    [LA.c, LA.h, beta1.h, buspirateNG.h, protocols.c]
2018-02-26 - added DFU bootloader - added #, $ as command (jump into bootloade/reset)
    [UI.c, UI.h, usbdfu.c]
2018-03-02 -fixed logic analyzer -fixed bug in userinput
    [LA.c, LA.h, UI.c]
2018-03-19 open latch to probe sram pins
2018-03-20 add spi la changes
2018-03-23 Revert "fixed unused variable"
    This reverts commit 46a14085b95fabf4c57e2ae5b59cb056e28aa3ca.
    [sump.c]
2018-03-23 - fixed lockup in commandline - fixed 'randomly' sent NULL chars
    [UI.c, cdcacm.c]
2018-03-23 Revert "Revert "fixed unused variable""
    This reverts commit 1c3654b1548de7b261ad4106a16f7bc4517599f1.
    [sump.c]
2018-03-24 Logic analyzer current progress. Reverted change in cdcacm that was causing freezing
    [LA.c, cdcacm.c, sump.c]
2018-03-27 - finally (?) fixed NULL bug in cdcacm - added direct io mode
    [DIO.c, DIO.h, beta2.h, cdcacm.c, protocols.c, protocols.h]
2018-03-28 added LCD(SPI) mode; just HD44780 is available yet
2018-03-29 add logic analyzer to various modes. send null samples when reach end of data in large capture request for live captures
2018-04-03 switched to interrupts for usb communication
2018-04-06 induce warning and error
    [LA.c]
2018-04-10 - finally fixed cdc (?) - cosmetic changes to function names
    [UI.c, buspirateNG.c, cdcacm.c, cdcacm.h]
2018-04-12 - added 1 wire protocol (not working atm) - added place holder for I2C LCD protocol
    [1WIRE.c, 1WIRE.h, beta2.h, buspirateNG.h, protocols.c, protocols.h]
2018-04-16 - added a timer for proper delays - fixed 1 wire - added device list to 1wire from http://owfs.sourceforge.net/simple_family.html
    [1WIRE.c, UI.c, UI.h, beta2.h, buspirateNG.c]
2018-04-19 - renamed ST7735R to ST7735 as it support D and R versions - added subprotocolname to commandline - added menu to LCD library to choose which display is being probed - minor UI tweaks
2018-04-23 - added timeout to I2C - added short/no pullup check to I2C - added address search macro to I2C
    [HWI2C.c, beta2.h]
2018-04-26 - HW init is now done just before the first command that interacts on the bus; this will allow to properly setup the powersupplies before interacting - fixed bug in pinstate display
    [HiZ.c, UI.c, UI.h]
2018-05-01 - added 2 documents that has the real addresses of the HW register; useful for debugging with commandline gdb - enabled opendrain for HW spi mode
2018-05-07 - added 2 SPI sniffers - added SPI macro's for setting cpol and cpha
2018-05-08 - fixed compile errors introduces by last commit - added I2C sniffer (WIP)
    [HWI2C.c, HWSPI.c, sniffer.c]
2018-05-09 - added uart macros - added defines for sniffers to platform defines
2018-07-10 - fixed the selftest mode
    [buspirateNG.c, selftest.c]
2018-09-13 Bus Pirate NG1 alpha 3 hardware
    [BusPirate-ng.v1.0.GBL, BusPirate-ng.v1.0.GBO, BusPirate-ng.v1.0.GBP, BusPirate-ng.v1.0.GBS, BusPirate-ng.v1.0.GTL, BusPirate-ng.v1.0.GTO, BusPirate-ng.v1.0.GTP, BusPirate-ng.v1.0.GTS]
